cbm-instructions/teamrocket/2024-01-29-teamrocket.markdown

---
title: "React to Snack"
categories: instructions
layout: post
date: 2024-01-29 14:00:00 +0200
---

# Die Arcade Machine mit Snackpreisen

# Inhaltsverzeichnis

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

# Motivation

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

Alternativer Text

# Vorbereitung

## Werkzeuge

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

## Material

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

## Empfohlene Vorkenntnisse

- Löten
- Lasercutten
- Grundlegender Umgang mit dem Arduino
- Arduino Programmierung (falls man das Programm anpassen möchte)

# Bauanleitung

## Gehäuse

Hierbei werden die folgenden SVGs benötigt:

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

Für den Bau des Gehäuses entschieden wir uns dazu, Sperrholzplatten zu benutzen. Die Sperrholzplatten wurden mit dem
Vektorgrafik-Programm Inkscape erstellt und können mithilfe des Lasercutters ausgeschnitten werden. Die dafür benötigten
SVG-Dateien sind
im [SVG Verzeichnis](/images/teamrocket/svgs/) zu finden.

Nachdem alle Platten vom Lasercutter geschnitten wurden, wird der Automat vorerst nur zusammengesteckt und nicht
verklebt.

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

Die zusammengesteckten Teile können mithilfe von Klebeband vorerst stabilisiert werden, sollten aber nicht verklebt
werden.

Die Plexiglasscheibe wird ganz zum Schluss reingeschraubt.

Alternativer Text

## Ausgabevorrichtung

Hierbei werden die folgenden SVGs benötigt:

- [sensor_blocker.svg](/images/teamrocket/svgs/sensor_blocker.svg): Die an einem Motor befestigte Platte, die durch eine Laserschranke
  fährt, um dem Motor zu
  signalisieren, dass er sich nicht weiter drehen soll (wir nennen ihn "Lichtblocker").
- [inner.svg](/images/teamrocket/svgs/inner.svg): Ein weiterer Lichtblocker für den zweiten Motor und die beiden inneren Platten, die die
  Spiralen für den
  Ausgabemechanismus tragen, sowie die Trennplatten, die die Spiralen voneinander trennen.

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

Alternativer Text

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

Alternativer Text

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

Alternativer Text

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

Hier sieht man den Stabilisator auf der Unterseite der Innenplatte:

Alternativer Text

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

Alternativer Text

## Farbe und Design

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

Alternativer Text

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

Zuletzt können die [Spielanleitung](/images/teamrocket/svgs/instruction.svg) und die [Labels](/images/teamrocket/svgs/instruction.svg) für die Snack-Buttons
an den Automaten geklebt werden. Die Position
kann frei gewählt werden.

## Software und Technik

Hierbei wird die folgende SVG benötigt:

- [arduino_platte.svg](/images/teamrocket/svgs/arduino_platte.svg): Die Holzplatte, an die die Platine und der Arduino befestigt werden.

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

Alternativer Text

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

Alternativer Text

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

# React to Snack - Demo

## Spielanleitung

Spielanleitung

## Gewinnen

Snack Gewinnen

## Verlieren

Verlieren

# Ausblick

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

# Team Rocket

- Alexander Obwandner
- Andreas Latanowsky
- Filip Cavar
- Sven Hoffmann
