cbm-instructions/teamrocket/images/IMG_20240109_105032.jpg

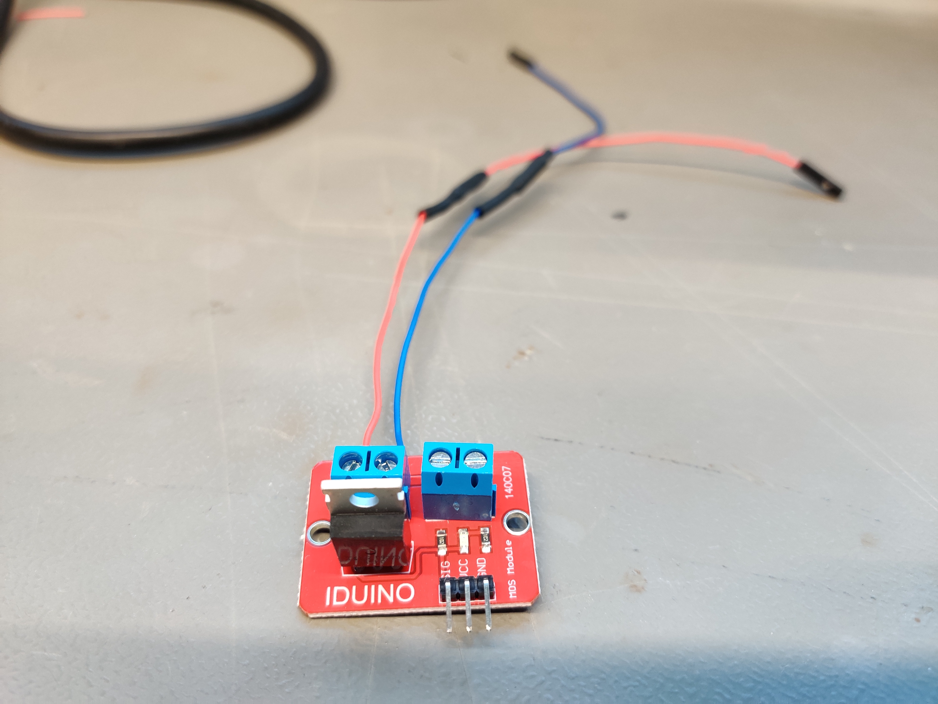
images/IMG_20240109_105032.jpg
