cbm-instructions/teamrocket/images/IMG_20240109_105039.jpg

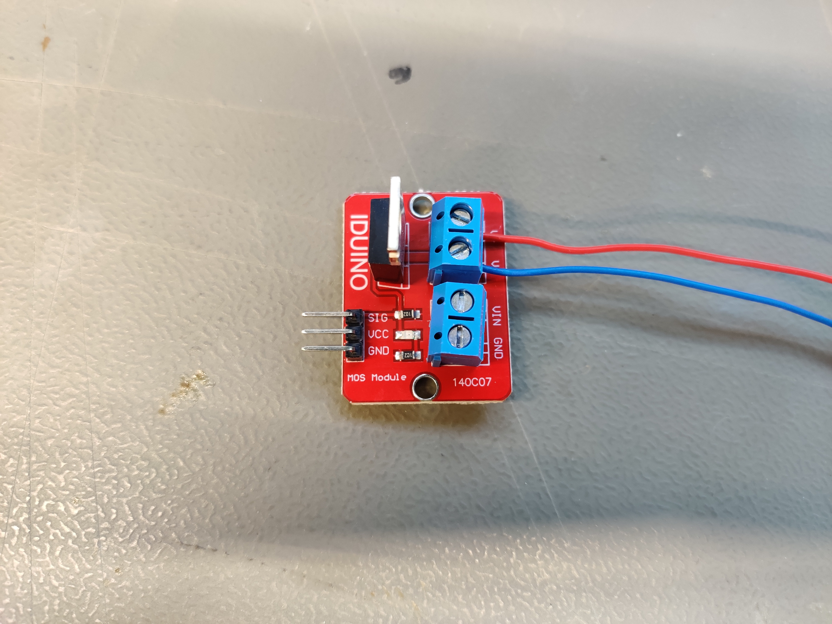
images/IMG_20240109_105039.jpg
