cbm-instructions/teamrocket/(commit log)

2024-01-20 Gehäuse und Innenplatten Bauanleitung
2024-01-26 Rechtschreibfehler korrigiert und Technikpart geschrieben
2024-01-28 Textanpassungen, neuer Abschnitt "Demo" und neue Bilder
2024-01-28 arduino platte
2024-01-29 added Mitglieder Auflistung und Programmcode Link
