cbm-instructions/teamrocket/images/IMG_20240109_114448.jpg

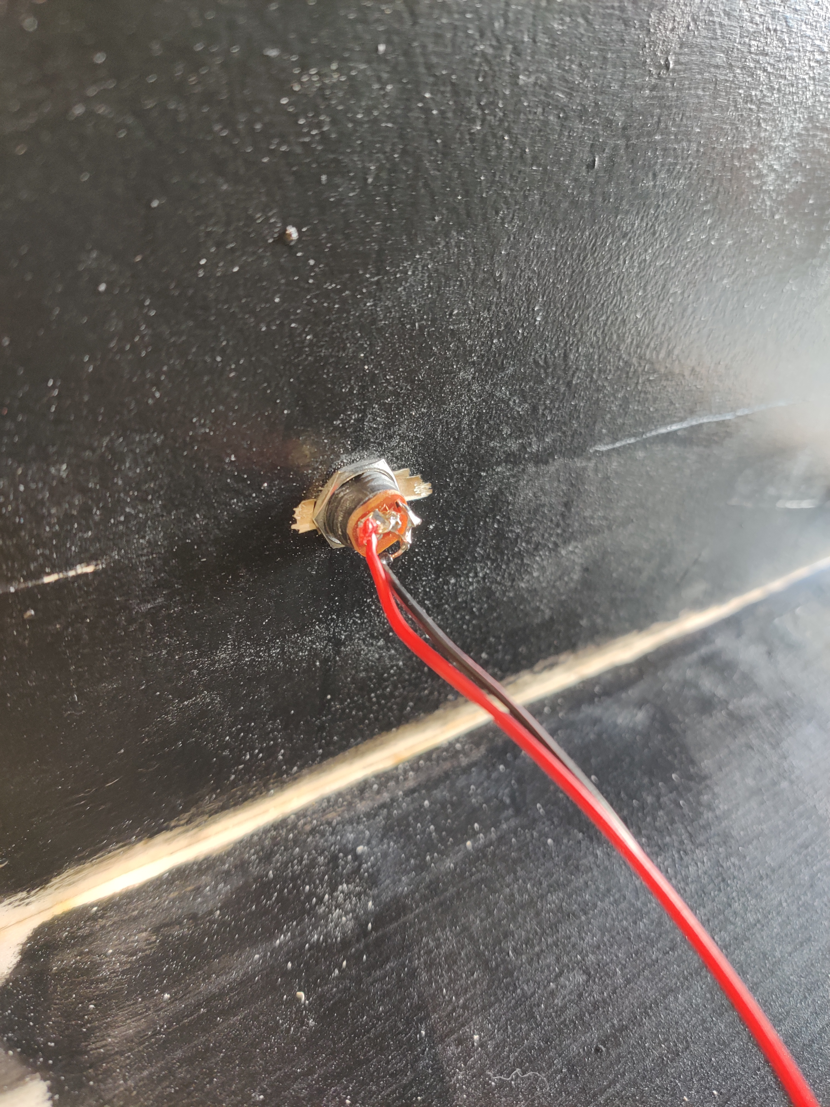
images/IMG_20240109_114448.jpg
