cbm-instructions/teamrocket/images/IMG_20240110_135805.jpg

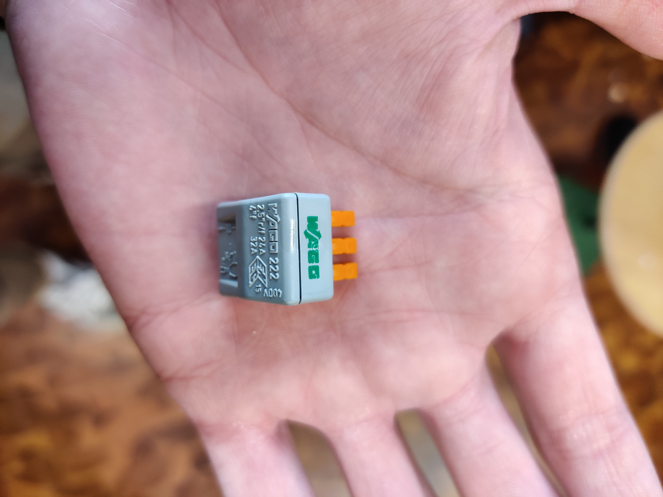
images/IMG_20240110_135805.jpg
