cbm-instructions/teamrocket/Automat_placeholder.jpg

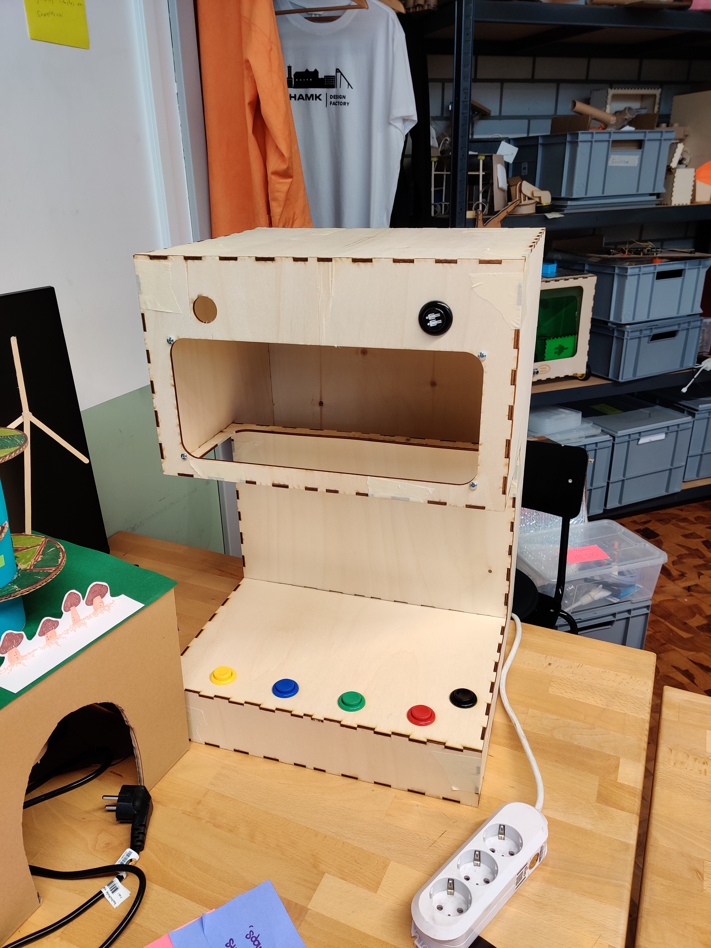
[picture p2: images/Automat_placeholder.jpg]
Automat_placeholder.jpg
