cbm-instructions/teamrocket/Acryl.jpg

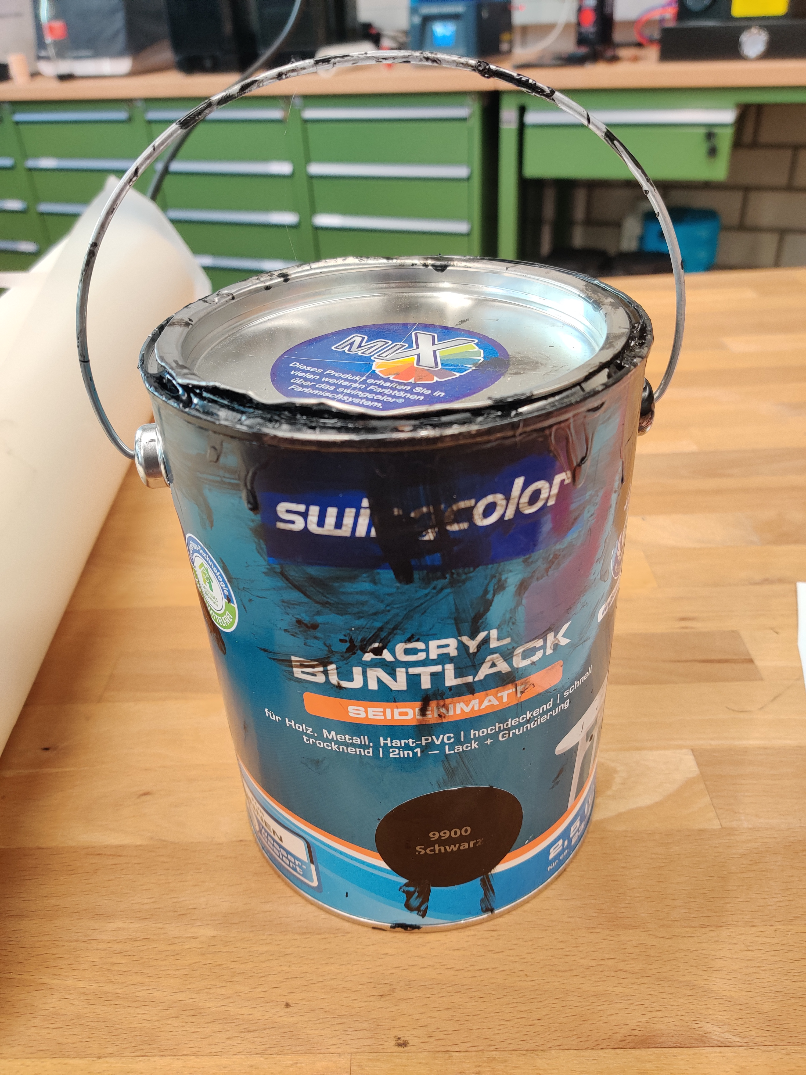
[picture p6: images/Acryl.jpg]
Acryl.jpg
